lizeyan/Spider/README.md

# Spider
---
A Spider powered by Arduino Mega.
There is a document in the root directory.
