lizeyan/Spider/source/distance.h

#ifndef ___DISTANCE___
#define ___DISTANCE___
class HardwareSerial;
const int distanceNum = 3;
const int distanceIn[distanceNum] = {2, 4, 6};
const int distanceOut[distanceNum] = {3, 5, 7};
class Distance
{
  public:
    int distance(int rank = 0) {
      return distances[rank];
    }
    //返回距离，单位是毫米
    int operator[] (int rank) {
      return distances[rank];
    }
    void update();//更新距离，每回合都应当调用一次
    void emit();//发射触发超声传感器的信号
    void setup();//初始化
    void echo (int rank = 0);//在蓝牙上显示
    void echoAll();//显示全部
    Distance();
  private:
    int distances[distanceNum];
    HardwareSerial* serial[4]; 
};
#endif
