lizeyan/Spider/(commit log)

2015-12-19 最初的版本，可以控制传感器
2015-12-21 加入了舵机控制的代码，多级角度修正还没有加;加入了距离更新显示获得的代码;光强暂时没有加
2016-01-17 设计文档
